wiredopposite/OGXHUB/Gerbers/README.md

# Both OGXHUB and X2USB PCBs should be manufactured with a thickness of 1.0mm
BOM for each board can be found [here](https://github.com/wiredopposite/OGXHUB/tree/main/BOM).

OGXHUB PCB
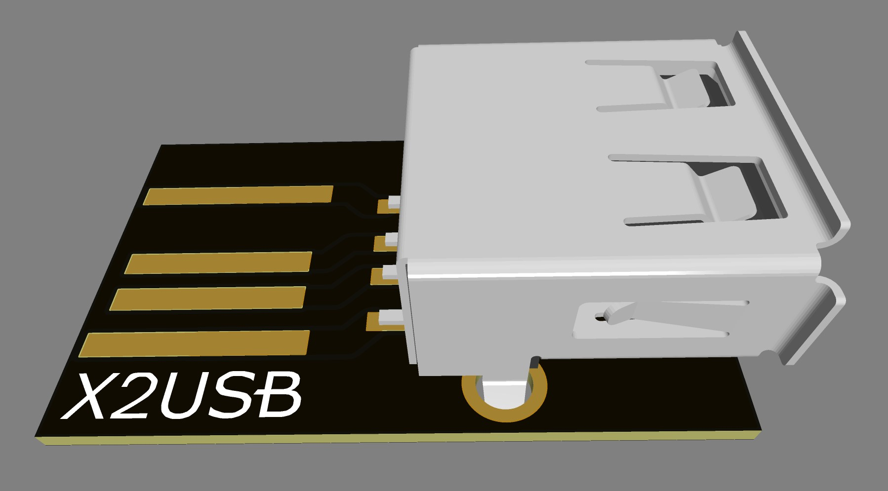
[picture p2: Pictures/x2usb.jpg]
X2USB PCB
