wiredopposite/OGXHUB/OGX360 3D Printed Internal Mount/OGX360 Caddy Bottom v.1.4.stl

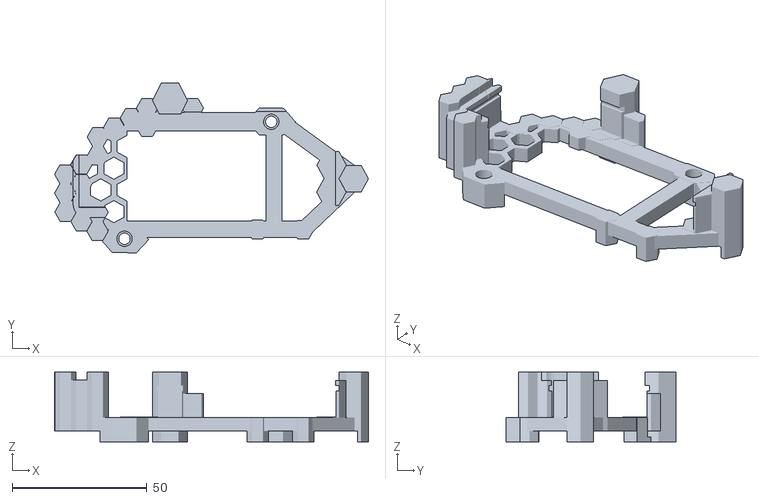
[picture p3: CAD file, 2023-01-06]
OGX360 3D Printed Internal Mount/OGX360 Caddy Bottom v.1.4.stl
116.7 x 63.1 x 25.9
