wiredopposite/OGXHUB/OGX360 3D Printed Internal Mount/OGX360 Caddy Top v.1.4.stl

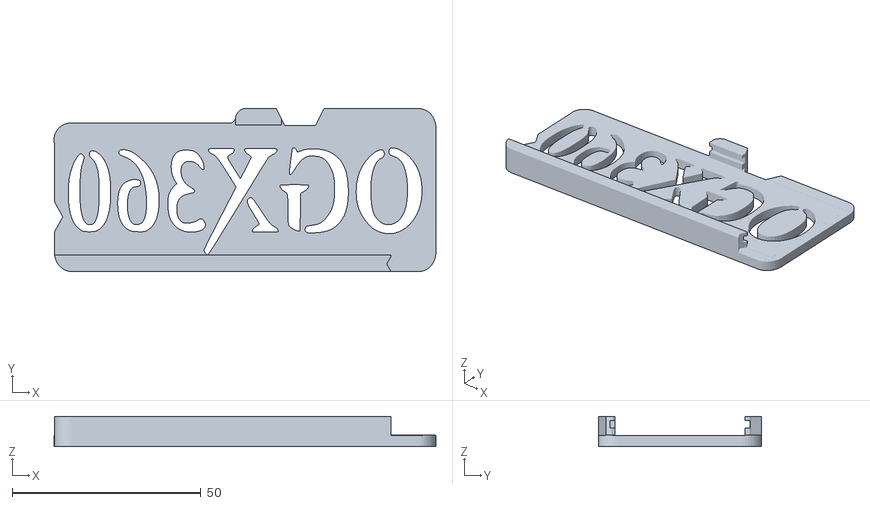
[picture p4: CAD file, 2023-01-06]
OGX360 3D Printed Internal Mount/OGX360 Caddy Top v.1.4.stl
101.1 x 43.2 x 8.00
