wiredopposite/OGXHUB/OGXHUB_1.2_Schematic.pdf

## +5V from Xbox

## Power Switch

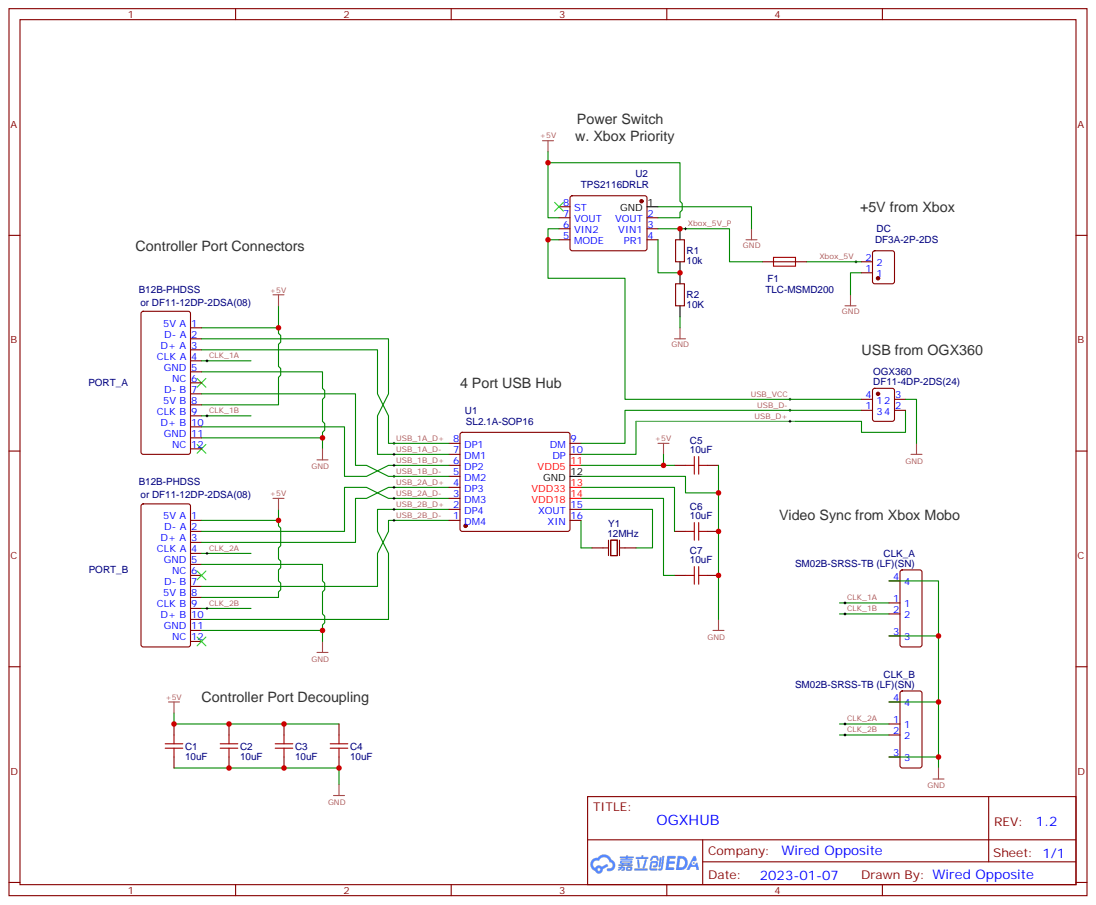
[picture p5: page 1]

Video Sync from Xbox Mobo

SM02B-SRSS-TB (LF)(SN)

Drawn By: Wired Opposite
