wiredopposite/OGXHUB/Cables/OGXHUB Cable Diagram.pdf

# OGXHUB Cable Diagram

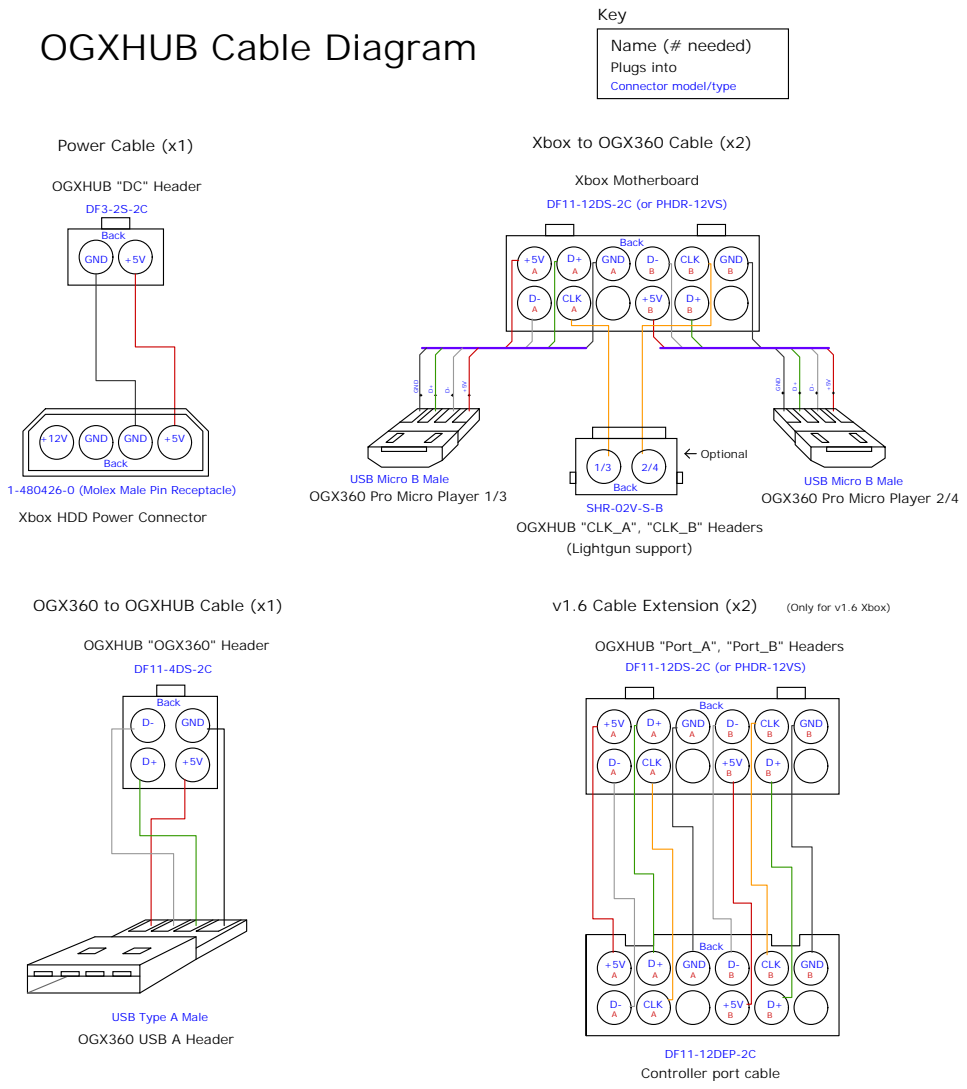
[picture p6: page 1]

1-480426-0 (Molex Male Pin Receptacle)
Xbox HDD Power Connector
