wiredopposite/OGXHUB/OGX360 3D Printed Internal Mount/README.md

Note: This is not compatible with Philips DVD drives.

This mount makes installing the OGX360 internally very simple, only the bottom portion of the mount is required. Just screw the mount in with the original motherboard screws and snap the OGX360 into place. 

Thank you to TEK Nemesis for these STL files.

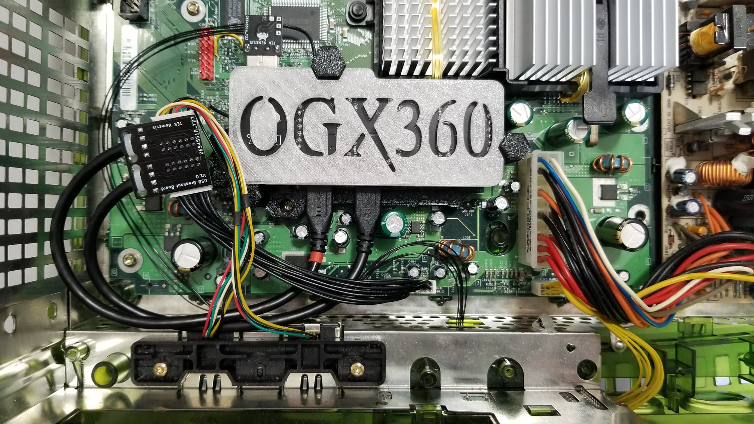
[picture p7: OGX360 3D Printed Internal Mount/197873537_528583128512562_3041646456073908682_n.jpg]
OGX360 Mount
