wiredopposite/OGXHUB/(commit log)

2023-03-09 Update and rename 1 to PCB BOM
2023-03-09 Rename PCB BOM to README.md
